missing-user/co2/README.md

# co2
The accompanying code (and some of the test sketches) of my term paper about CO2 levels in classrooms.
